cheyao/aniprinter/CAD/ATTRIBUTION.md

3D Model Credit:

E3D V6.step: https://grabcad.com/library/e3d-v6-hotend-3
e3d titan.stp: https://grabcad.com/library/e3d-titan-extruder-2
Radial-Cooling-Fan-5015-DC12V.STEP: https://grabcad.com/library/radial-cooling-5015-fan-50mm-dc12v-1/details?folder_id=2074285

Special thanks to FreeCAD Makers Library and Fasteners Library devs.
