cheyao/aniprinter/CAD/render.png

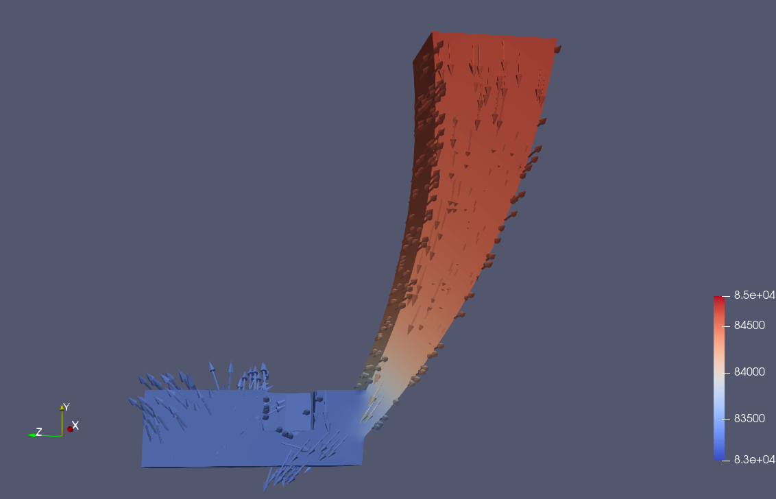
CAD/render.png
