cheyao/aniprinter/models/assembly.FCStd

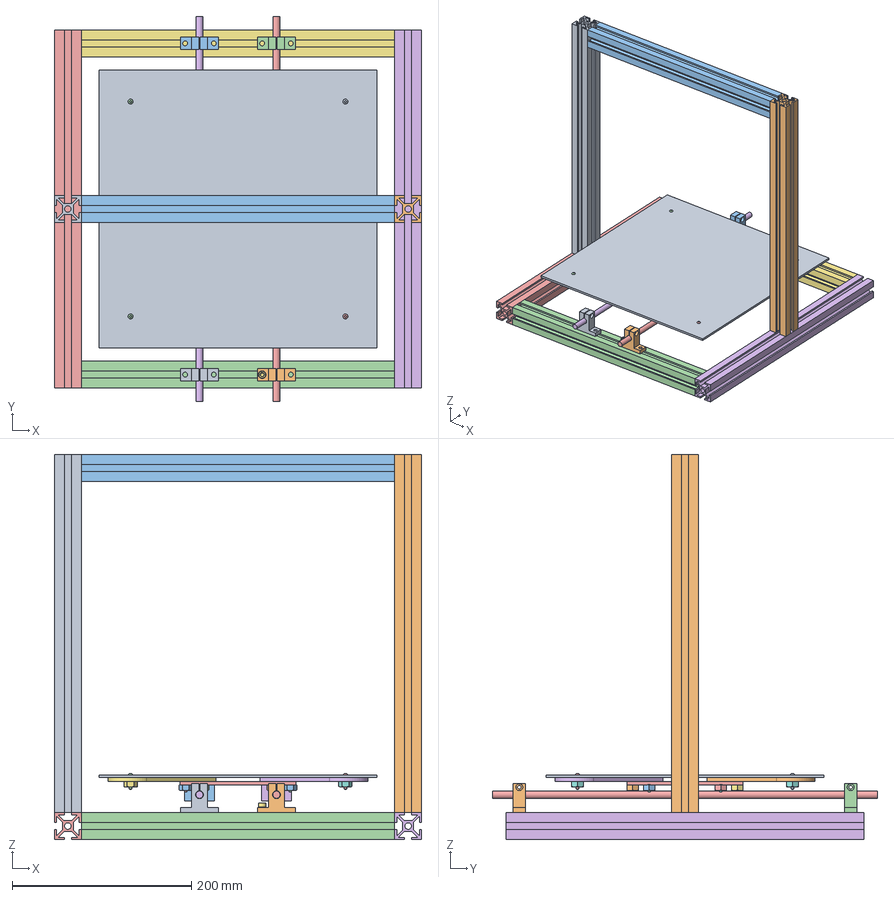
[picture p2: CAD file, 2025-02-18]
models/assembly.FCStd
410.0 x 430.0 x 430.0 mm
shaft8_holder
shaft8_holder001
shaft8_holder002
shaft8_holder003
Linear Rod A
Linear Rod B
M8-Nut052
M8-Nut051
M8-Nut048
M8-Nut046
M8-Nut043
M8-Nut042
M8-Nut049
M3x16-Screw022
M8-Nut
M3x16-Screw021
M3x16-Screw020
M3x16-Screw015
M8-Nut045
M3x16-Screw014
M3x16-Screw012
M8-Nut050
Plate Holder B
Plate Holder A
Heatbed
Plate Holder D
Linear Bearing A
M3x16-Screw019
M3x16-Screw018
Plate Holder C
M3x16-Screw017
M8-Nut044
M3x16-Screw013
M3x16-Screw016
M8-Nut047
M3x16-Screw
Plate Holer Base
Linear Bearing B
M5x14-Screw
M5 x 30/40 series-TSlot
aluprof_036
aluprof_037
aluprof_038
aluprof_30
aluprof_031
aluprof_032
aluprof_033
