cheyao/aniprinter/CAD/fluidsym.FCStd

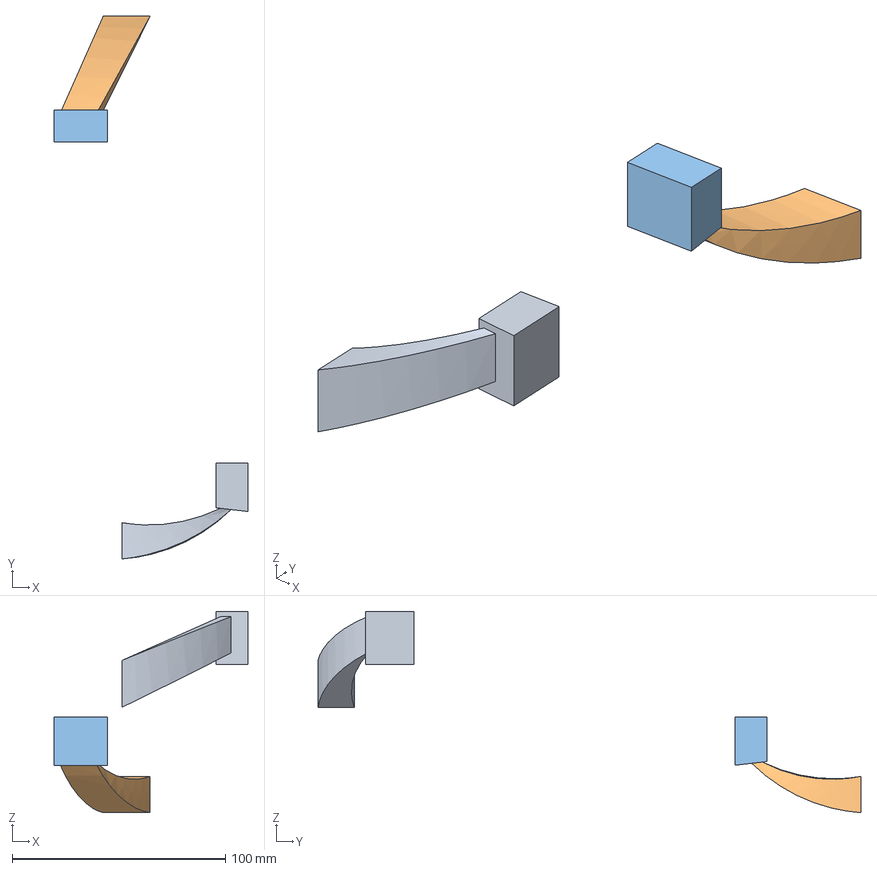
[picture p3: CAD file, 2025-03-02]
CAD/fluidsym.FCStd
90.9 x 254.7 x 94.5 mm
wall
outlet
inlet
