cheyao/aniprinter/CAD/hotend.FCStd

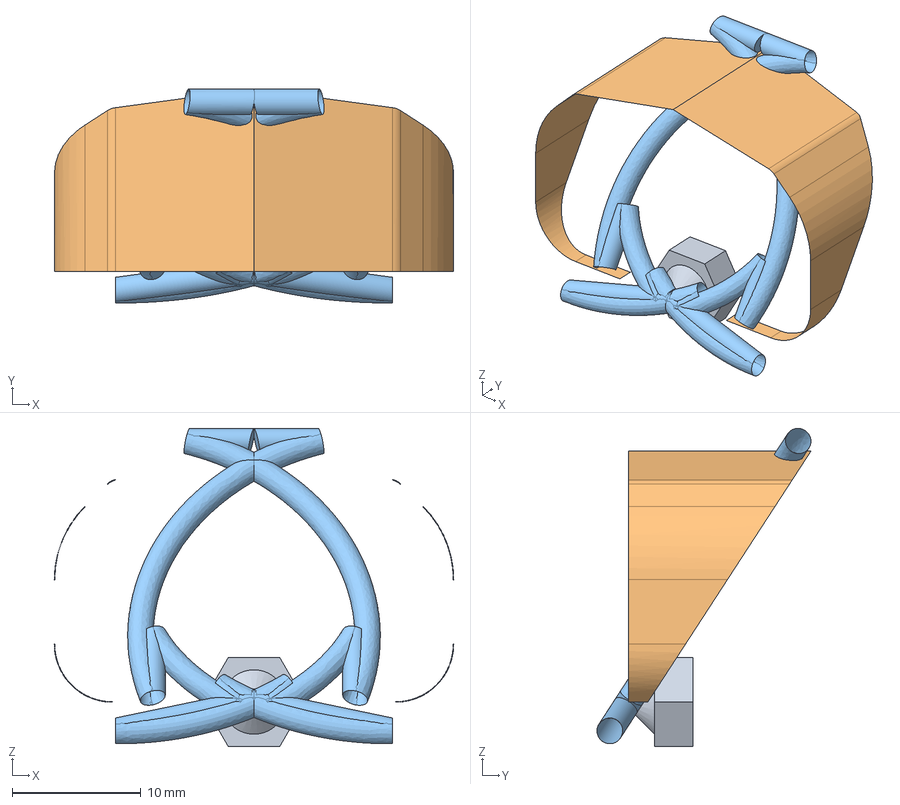
[picture p4: CAD file, 2025-02-24]
CAD/hotend.FCStd
31.0 x 16.6 x 24.7 mm
Hotend
