cheyao/aniprinter/(list of files, cad)

Other CAD files:
CAD/animmu.FCStd
