cheyao/aniprinter/PCB/UwUstatus/UwUstatus.kicad_pcb

## KiCad design PCB/UwUstatus/UwUstatus.kicad_pcb (2025-04-04)

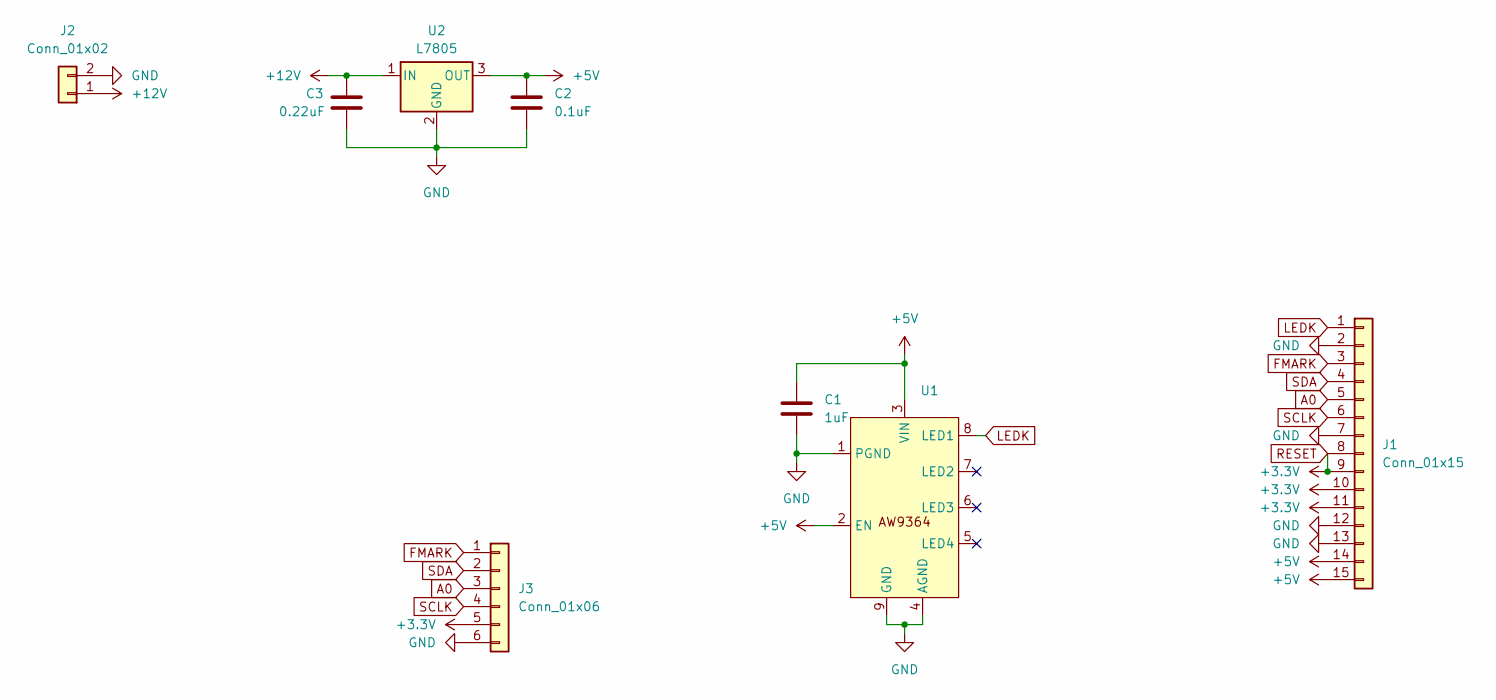
[picture p5: schematic UwUstatus.kicad_sch]

Parts:
C1: 1uF; C_0805_2012Metric_Pad1.18x1.45mm_HandSolder
C2: 0.1uF; C_0805_2012Metric_Pad1.18x1.45mm_HandSolder
C3: 0.22uF; C_0805_2012Metric_Pad1.18x1.45mm_HandSolder
J1: Conn_01x15; Hirose_FH26-15S-0.3SHW_2Rows-15Pins-1MP_P0.60mm_Horizontal
J2: Conn_01x02; TerminalBlock_Phoenix_MKDS-1,5-2-5.08_1x02_P5.08mm_Horizont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
J3: Conn_01x06; PinHeader_1x06_P2.54mm_Vertical
U1: DFN-8-1EP_2x2mm_P0.5mm_EP0.6x1.2mm
U2: L7805; TO-252-2

Connections:
+5V: C1.1, C2.1, J1.14, J1.15, U1.2 (EN), U1.3 (VIN), U2.3 (OUT)
+12V: C3.1, J2.1, U2.1 (IN)
A0: J1.5, J3.3
FMARK: J1.3, J3.1
GND: C1.2, C2.2, C3.2, J1.2, J1.7, J1.12, J1.13, J2.2, J3.6, U1.1 (PGND), U1.4 (AGND), U1.9 (GND), U2.2 (GND)
LEDK: J1.1, U1.8 (LED1)
RESET: J1.8, J1.9, J1.10, J1.11, J3.5
SCLK: J1.6, J3.4
SDA: J1.4, J3.2

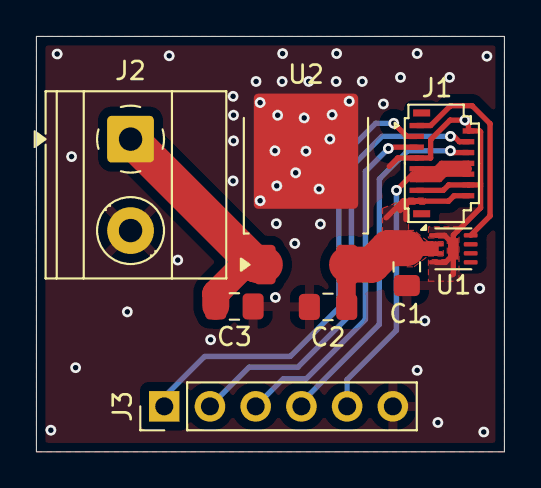
[picture p6: board UwUstatus.kicad_pcb from above]

Board: 2 copper layers, 26.0 x 23.1 mm, 8 parts (0 on the bottom side), 9 nets.
