cheyao/aniprinter/JOURNAL.md

# Aniprinter - The anime printer :3

Anime printer!!! I'm gonna add some cat ears lol

Made by: @Cyao

Respository link: https://github.com/cheyao/aniprinter

Hours so far: 75.5h

- [x] I have a bambu A1 mini and access to larger school printers

Printer for my ani* set of hardware!

## The plan

I don't fucking know but I'll figure it out in the vacations. I never failed anything when money isn't a constraint :D

1. Hella cheap
2. Capable of printing figurines
3. 310x310x310+mm
4. Cute & colorful
5. Have removable cat ears on it :3 (Dad's killing me if he sees cat ears TwT)
( 6. Multicolor!!! 8+ colors! I'll whip something up with my parts :3)
Extra: Be able to print some metalic filament, that would be soo cool

How to source the parts cheaply? I'm buying everything from china lol

Currently the outline is 400mm x 410mm

### Log

| Date  | Task | Time | Notes |
| ----- | --- | --- | --- |
| 02/02 | Init | 20 min | Yay (Including time spent later on README.md) |
| 03/02 | Finding parts in my home | 1 hour | Fuck how did I use soo long to do this, my parts are too many and disorganised. |
| 05/02 | Defining requirements | 10 min | Hmm what are my needs |
| 16/02 | Searching parts in china | 3 hours | Big kudos to @Anicetus for helping me :3 |
| 17/02 | Searching then designing in FreeCAD  | 6.5 hours | Legit spent whole afternoon |
| 18/02 | More parts and modeling | 8 hours | Ahh assembly workbench is bad |
| 19/02 | Motors | 6 hours | I'm getting better at this :D |
| 2?/02 | Clamps | 1 hour  | :D |
| 2?/02 | Making bed movable | 3.5 hour  | Hard... Plus just found freecad has hole feature... |
| 2?/02 | Finish Y axis | 3 hours | Yay |
| 21/02 | Start of Z axis | 4 hours | Looks nice :P |
| 22/02 | Finished Z axis!!! | 5 hours | Only printhead and electonics to go |
| 23/02 | Working on head | 5 hours | Only printhead and electonics to go |
| 24/02 | Tiny bit of research | 5 min | Continuing... |
| 26/02 | Trying to get CFD work | 6 hours | I hate openfoam... |
| 28/02 | More mats | 2 hours | Ahh taobao locked my account |
| 01/03 | PCB | 3 hours | :D |
| 02/03 | CFD + X axis | 6 hours | Fuck yeah! |
| 03/03 | Counting screws | 1 hour  | I lost track :heavysob: |
| ~ | Getting printer & approved + planning | 2 hours | Welp |
| 27/03 | Ordering everything | 4 hours | Kudos to anicetus again <3 |
| 28,29,30,31,01/03 | Fixing orders, ordering more, solving shipping, yapping with merchants that doesn't want to ship, refunding from merchants that doesn't wanna ship, and mooooreee ordering | 7 hours | Ah china = complex |
| 04/04 | Order PCB and final buying stuff (before yesterday) | 4 hours | Nyaa |

## BOM

At home:
- 2x (I should have 4???) PX245-01A 2 phase stepper motors from 2015 lol
- 1x Microstep Driver TB6600-4.0 from fucking 2014

1 RMB = 0.14 USD

| Part Name | Num | Price RMB (USD) | Link |
| --- | ----- | --- | ---- |
| 310x310mm Heatbed w/ cable | 1x | 56.84 (7.96) | [link](https://item.taobao.com/item.htm?id=640200686112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) |
| 310x310mm Plate | 1x | 46 (6.44) | [link](https://item.taobao.com/item.htm?id=623211529831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) |
| 8mm Shaft holder | 4x | 1.12 (0.15)  | [link](https://item.taobao.com/item.htm?id=680885766109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) |
| 3030 Alu extrusion (7x400mm) | 2.8m (+0.2 extra) | 20.21/m + 6 shipping (2.83/m + 0.84) | [link](https://item.taobao.com/item.htm?id=709479736047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) |
| 2 430mmx8mm 2 420x8mm Linear rods | 4x | 8/m (1.15)| [link](https://item.taobao.com/item.htm?id=705312506425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) |
| PTFE tubes | 3m | 1.2/m (0.17) | [link](https://item.taobao.com/item.htm?id=815502974789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) |
| L 5-hole connector for 3030 | 6x | 5.3 (0.73) | [link](https://item.taobao.com/item.htm?id=544614918944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)
| T 5-hole connector for 3030 | 2x | 5.3 (0.73) | [link](https://item.taobao.com/item.htm?id=544614918944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)
| 8mm Linear Bearing Slot | 2x | 2.8 (0.38) | [link](https://item.taobao.com/item.htm?id=560816782190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) |
| 8mm Linear Bearing | 4x | 1.08 (0.15) | [link](https://item.taobao.com/item.htm?id=596588093773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) |
| NEMA17 40mm Stepping Motor | 5x | 12 (1.58) | [link](https://item.taobao.com/item.htm?id=649664531631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) |
| NEMA17 (Type 42) Mounting Plate  | 4x | 2.1 (0.29) | [link](https://item.taobao.com/item.htm?id=568647933856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) |
| 2GT Timing Pulley 20T 6W 5 Inner | 2x | 0.9 (0.12) | [link](https://item.taobao.com/item.htm?id=559194333476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) |
| 2GT Idler 20T 6W 5 Inner | 2x | 1.2 (0.17) | [link](https://item.taobao.com/item.htm?id=559682437946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) |
| 2GT Rubber Belt | 2m | 1.25 (0.18) | [link](https://item.taobao.com/item.htm?id=558903222636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) |
| 8mm Lead Screw 400mm | 2x | 8.3 (1.14) | [link](https://item.taobao.com/item.htm?id=559693268692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) |
| 5x8 Lead Screw Adapter | 2x | 0.9 (0.12) | [link](https://item.taobao.com/item.htm?id=558851617070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) |
| KFL08 Lead Screw Holder | 2x | 2.43 (0.34) | [link](https://detail.tmall.com/item.htm?id=748242575487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) |
| 380mm Linear Rail MGN9 | 1x | 4 (0.48) | [link](https://item.taobao.com/item.htm?id=675423855075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) |
| MGN9 Block Guide | 1x | 8.5 (0.96)  | [link](https://item.taobao.com/item.htm?id=675423855075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) |
| E3D V6 hotend 24V50W (远程) | 1x | 22.8 (3.19)  | [link](https://item.taobao.com/item.htm?id=695145988184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) |
| BIGTREE SKR MINI E3 Mainboard | 1x | 203 (27.89) | [link](https://item.taobao.com/item.htm?id=660038613435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) |
| 3D touch | 1x | 37 (5.10) | [link](https://item.taobao.com/item.htm?id=594093806947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)
| Extruder (Need NEMA17) | 1x | 12 (1.66) | [link](https://item.taobao.com/item.htm?id=632506457890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)
| Fan 5015 | 1x | 9 (1.24) | [link](https://item.taobao.com/item.htm?id=612218714981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) |
| 3D Printer Holder | 1x | 69 (9.47) | [link](https://item.taobao.com/item.htm?id=704269813634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) |
| 10mm Diam 20mm Height Spring | 4x | 1 (0.14)  | [link](https://item.taobao.com/item.htm?id=721543036692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) |
| 24V 400W 16.5A Power Supply | 1x | 50 (6.87) | [link](https://item.taobao.com/item.htm?id=616623109443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) |
| M3 35mm Sink Bolts | 4x | 1.1 for 20 (0.17) | [link](https://detail.tmall.com/item.htm?id=729847299973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) |
| M3 8mm Sink Bolts | 4x | 3.4 for 100 (0.47) | [link](https://detail.tmall.com/item.htm?id=729847299973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) |
| M3 10mm Bolts | 53x | 2.7 for 50 (0.37) | [link](https://detail.tmall.com/item.htm?id=729847299973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) |
| M3 22mm Bolts | 26x | 3.5 for 50 (0.48) | [link](https://detail.tmall.com/item.htm?id=729847299973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) |
| M3 Nuts | 34x | 1.65 for 100 (0.22)| [link](https://detail.tmall.com/item.htm?id=549640610734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) |
| M3 4.2W3H Heat insert | 6x | 2.07 for 50 (0.29) | [link](https://detail.tmall.com/item.htm?id=809364062256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) |
| M3 T-Nuts for 3030 | 20x | 1.9 for 50 (0.26) | [link](https://item.taobao.com/item.htm?id=720521078724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) |
| M4 10mm Bolts | 12x | 2.1 for 20 (0.29) | [link](https://detail.tmall.com/item.htm?id=635755541429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) |
| M4 25mm Sink Bolts | 2x | 2.9 for 20 (0.40) | [link](https://detail.tmall.com/item.htm?id=729847299973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) |
| M4 Nuts | 14x | 2.65 for 100 (0.32)| [link](https://detail.tmall.com/item.htm?id=549640610734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) |
| M5 14mm Bolts | 10x | 2.1 for 20 (0.29) | [link](https://detail.tmall.com/item.htm?id=635755541429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) |
| M5 12mm Bolts | 10x | 2.1 for 20 (0.29) | [link](https://detail.tmall.com/item.htm?id=635755541429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) |
| M5 10mm Bolts | 12x | 2.1 for 20 (0.29) | [link](https://detail.tmall.com/item.htm?id=635755541429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) |
| M5 T-Nuts for 3030 | 10x | 1.4 for 50 (0.19) | [link](https://item.taobao.com/item.htm?id=720521078724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) |
| M6 12mm Bolts | 42x | 3.4 for 20 (0.45) | [link](https://detail.tmall.com/item.htm?id=635755541429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) |
| M6 T-Nuts for 3030 | 42x | 1.4 for 50 (0.19) | [link](https://item.taobao.com/item.htm?id=720521078724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) |
Maybe ASA for 46 rmb
- 1x mmu

Current total: 99.24 USD

TODO: CABLES!!!!!

PCB:
- 1x AW9364
- 1x 0.3K-HX-15PWB
- 1x 7805
- 1x WJ500V-5.08-2P

Screws:
- 52x M3 10mm
- 26x M3 22mm
- 34x M3 Nuts
- 20x M3 T Nuts
- 4x M3 35mm Sink Bolts
- 4x M3 8mm Sink Bolts
- 12x M4 10mm
- 2x M4 25mm Sink Bolts
- 14x M4 Nuts
- 10x M5 12mm
- 10x M5 T nuts
- 40x M6 10mm
- 40x M6 T nuts

Power consumption: 4*5W Motor + 230W Heatbed + 40W Heatend + 10W extra = 300W = 24V13A

I will ask my dad for shipping :D

15.93$ first 0.5kg, 10.16$ per next kg

5kg: 15.93 + 4.5 * 10.16 = 61.65$

## Pics
18/02/2025 Heatbed: 
21/02/2025 Y axis done and half done Z: 
22/02/2025 Z axis also done!  
23/02/2025 Print head assembly: 
02/03/2024 CFD:









02/03/2024 Base done!:





## Links:
- Motherboard: https://github.com/bigtreetech/BIGTREETECH-SKR-mini-E3/blob/master/hardware/BTT%20SKR%20MINI%20E3%20V3.0/Hardware/BTT%20E3%20SKR%20MINI%20V3.0_PIN.pdf
- 8x mmu https://github.com/Enraged-Rabbit-Community/ERCF_v2
https://blog.csdn.net/u012439969/article/details/143886683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
https://blog.csdn.net/m0_47060222/article/details/115832454

## Rant
Today I'm looking at YT vids of printers, they look fucking complex. But thats where the fun lies :P.

Ok fuck tutorials I'm going in blind

Note: motherboard uses JST-XH connectors
