cheyao/aniprinter/(commit log)

2025-02-22 All axis
    [E3D V6.3mf]
2025-02-23 Hotend assembly
2025-03-02 Base Done!
    [fluidsym.FCStd]
2025-03-03 Add screws!
2025-04-04 Final revision
    [UwUstatus.kicad_pcb, UwUstatus.kicad_sch, bom.csv, designators.csv, positions.csv]
2025-04-21 Add a bit of info to the README
    [animmu.FCStd]
